condrea44/Voltage_Regulator/Documentatie.pdf

Universitatea Națională de Știință și Tehnologie POLITEHNICA București

Facultatea de Electronică, Telecomunicații și Tehnologia

Informației Specializarea MON

## Circuite Electronice Fundamentale 2 – Proiect Stabilizator cu ERS

Student: CondreaCosmin

Grupa: 432E-MON

Anul: 2024-2025

## Cuprins:

1. Tema Proiectului | pg. 3
2. Schema Bloc | pg.4
3. Schema Electrică | pg.5
4. Componența Circuitului și Calcule de Dimensionare | pg.6
5. Simulări in OrCAD | pg.10
6. CalculAnalitic | pg.17

## Tema proiectului

Se proiectează un stabilizator de tensiune cu element de reglaj serie cu următoarele caracteristici: N=10

- Tensiunea de ieșire reglabilă în intervalul: 5V-10V
- Sarcina la ieșire 500Ω
- Deriva termică < 2mV/grad C;
- Protecție la suprasarcină prin limitarea temperaturii tranzistorului element de reglaj serie la 100 grade C și a curentului maxim la 0,4A;
- Tensiune de intrare în intervalul: 18V-20V
- Domeniul temperaturilor de funcționare: 0-70 grade C (verificabil prin testare în temperatură);
- Amplificarea în tensiune minimă (în buclă deschisă) a amplificatorului de eroare: minim 200;

## Schema Bloc

Un stabilizator de tensiune cu element de reglare în serie (ERS) utilizează un amplificator de eroare pentru a menține stabilitatea tensiunii de ieșire. Acest amplificator compară o parte din tensiunea de referință (REF) cu un semnal preluat de la ieșire printr-un circuit de reacție. Diferența rezultată determină ajustarea elementului de reglare, compensând astfel variațiile tensiunii de intrare sau ale sarcinii.

În plus, circuitul include mecanisme de protecție pentru a preveni deteriorările:

1. Protecție la suprasarcină – care evită deteriorarea componentei regulatorului în cazul unui curent prea mare.
2. Protecție termică – care oprește funcționarea dacă temperatura regulatorului depășește un nivel critic.

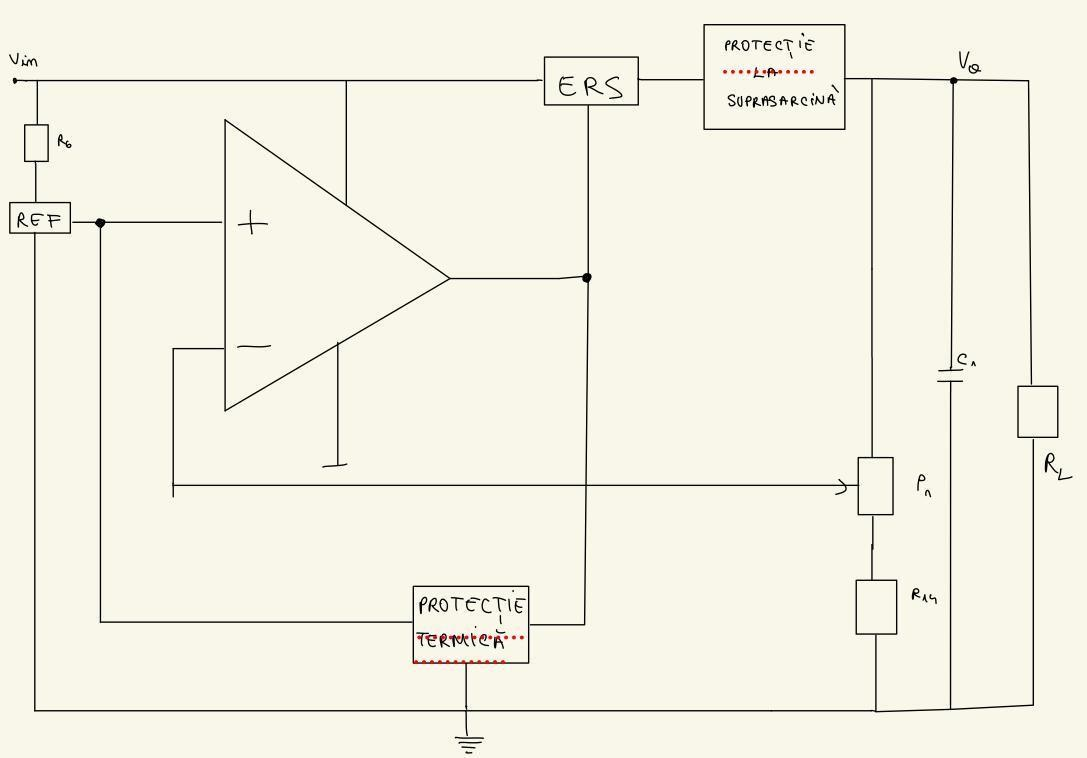
[picture p1: figure]

În schema dată, la intrarea neinversoare a amplificatorului de eroare este aplicată o tensiunea de referință (REF). La intrarea inversoare a amplificatorului de eroare este conectat un divizor rezistiv pentru a diviza Vout in funcție de ce valoare vrem să avem la ieșirea regulatorului.

Amplificatorul de eroare amplifica diferența dintre cele 2 intrări si comanda elementul de reglaj serie (ERS) pentru a stabiliza tensiunea de ieșire Vout.

## Schema Electrică

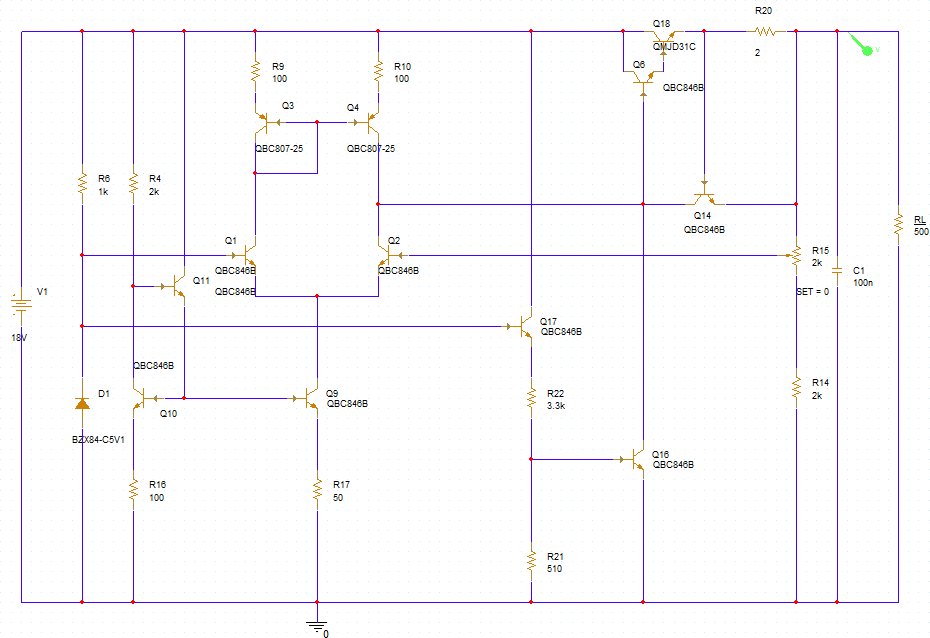
[picture p2: figure]

1. Amplificator de eroare: Q1, Q2, Q3, Q4, R9, R10 și generatorul de curent: Q9 ,Q10, Q11, R4, R16, R17;
2. Element de reglaj serie: Q6, Q18;
3. Referința de tensiune: D2;
4. Divizor de tensiune și rețea de reacție negativă: R15, R14;
5. Protecție termică: Q16, Q17, R22, R21;
6. Protecție la suprasarcină: Q14, R20;
Rezistor de sarcină: RL

## Componența Circuitului și Calcule de Dimensionare

1. Amplificatorul de eroare

Rolul amplificatorului de eroare este de a compara tensiunea de referință cu o fracțiune din tensiunea de ieșire. Diferența dintre acestea, este amplificată și folosită pentru a corecta funcționarea circuitului, asigurând menținerea unei tensiuni de ieșire stabile.

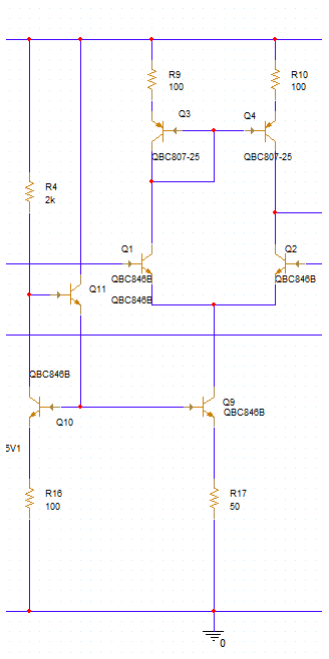
[picture p3: figure]

Amplificatorul de eroare este polarizat de o sursă de curent folosită in configurație de reducere a efectului de Beta. Acest tip de oglindă de curent folosește ca referință tensiunea bază-emitor și are o sensibilitate mai scazută față de alte oglinzi de curent. In etajul diferențial curentul dictat de dispozitivul Q9, se injumatațește. Putem observa ca etajul diferențial este format de Q1 si Q2 care au grilele la referințe de tensiune și sursele in scurt. Acesta conține o sarcină activă si 2 rezistoare ce impreună au ca scop creșterea amplificării in buclă deshisă, astfel oferind o tensiune de offset mai mică la ieșire. In urma numărarii etajelor de tip emitor comun, Q1 este intrarea neinversoare, iar Q2 este intrarea inversoare.

Dacă tensiunea de ieșire incepe să se modifice de la valoarea stabilită, diferența de tensiune va modifica la ieșirea diferențialului către ERS curentul astfel încât tensiunea de ieșire se va restabili.

2. Element de reglaj serie

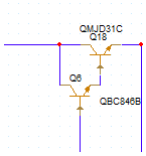
[picture p4: figure]

Perechea Darlington este o configurație de două tranzistoare bipolare conectate astfel încât primul tranzistor (Q6) preia semnalul de intrare, îl amplifică și furnizează un curent mai mare către baza celui de-al doilea tranzistor (Q18), care îl amplifică și mai mult. Rezultatul este un tranzistor compus cu un câștig total de curent aproximativ β1 * β2. Totuși, această configurație necesită o tensiune de prag mai mare 1.2V. Am folosit un tranzistor de putere intrucat pe acesta se disipa o putere maximă de aproximativ 0.2 W.

3. Referinta de tensiune

Referința de tensiune este realizată cu ajutorul unei diode Zener de tip BZX84-C5V, care menține o tensiune de străpungere stabilă de aproximativ 5.1V, atâta timp cât este traversată de un curent de cel puțin 5mA. Atunci când este alimentată cu un curent constant, această diodă prezintă un drift termic nesemnificativ în intervalul de temperatură 0 - 70°C, asigurând astfel o referință de tensiune precisă. Așa că am folosit un rezistor R6 cu valoarea rezistenței de 1kΩ pentru a produce un curent de 13mA in condițiile in care la intrare sursa de tensiune produce 18V.

4. Divizor de tensiune si rețea de reactie negativă

Datorită faptului ca am ales tensiunea de referință 5.1V am folosit un divizor rezistiv format dintr-un potențiometru si un rezistor de valori egale, astfel incat atunci când rotesc potențiometrul sa ajung la valorile conform cererii (5V-10V).

5. Protecția termică

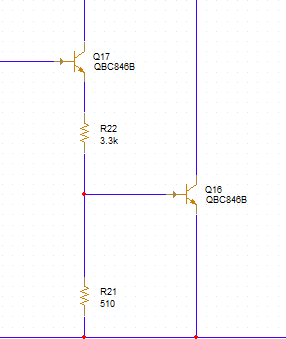
[picture p5: figure]

Am ales aceste valori ale rezistoarelor pentru a il folosi pe Q16 in regimul de blocare, pana cand temperatura circuitului crește la 100gradeC. In momentul in care se atinge această temperatură VBE-ul scade ( -2mV/°Celsius ) si astfel tranzistorul intră in conductie, trăgând tot curentul din iesirea amplificatorului si astfel provocând “Thermal Shutdown” cu scopul de a proteja componentele

6. Circuitul de protecție la suprasarcină

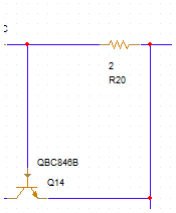
[picture p6: figure]

IO,lim = VBE14/R20 = 0.4A => R = 1.625Ω, dar am ales valoarea standard de 2Ω. Astfel, pentru curenți mai mici de 0.34A nu intră în funcțiune circuitul de protecție la suprasarcină, adica tranzistorul Q14 este în blocare.

## Simulări în OrCAD

I. Simulări pentru a arăta stabilizarea tensiunii de la iesire, in funcție de SET-ul potențiometruluiși tensiunea de intrare in circuit.

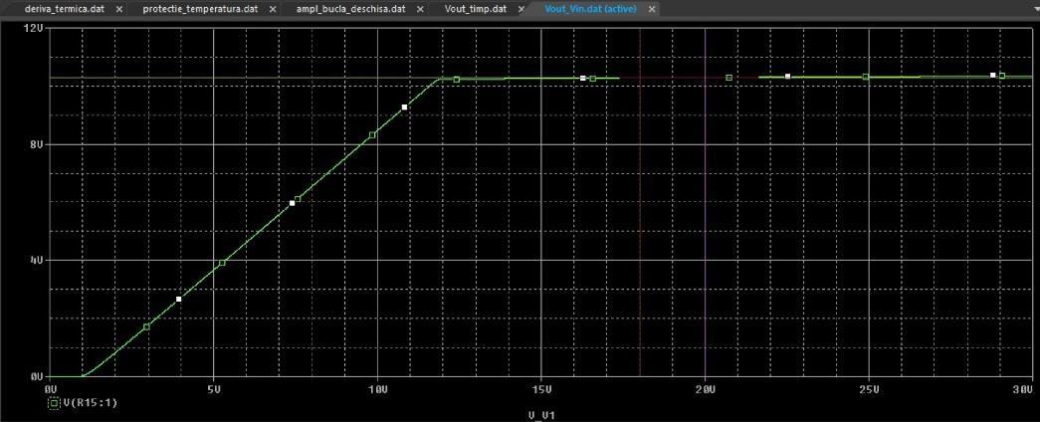
[picture p7: figure]

Vout= f(Vin) SET=0

Vout= f(Vin) SET=1

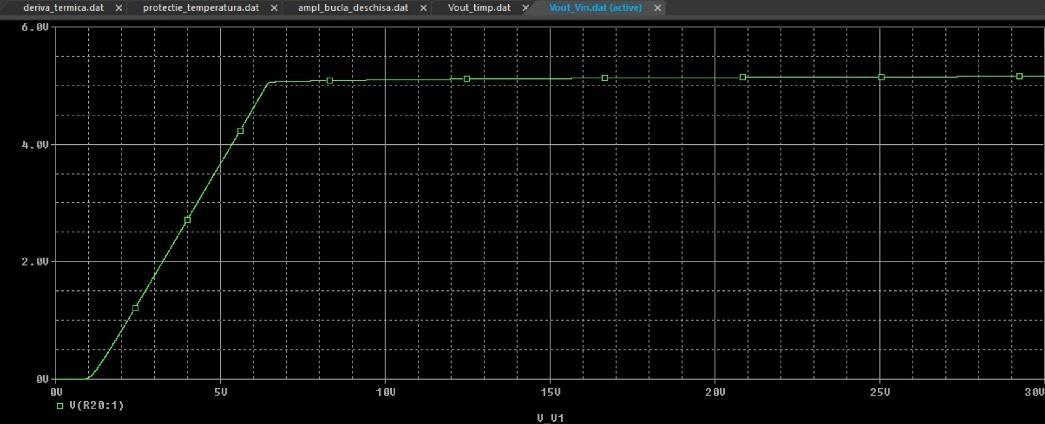
[picture p8: figure]

Se poate observa că tensiunea de ieșire Vout rămâne constantă atât în interiorul, cât și în afara intervalului de funcționare al tensiunii de intrare [5V - 10V]. Acest lucru demonstrează eficiența sistemului de feedback negativ, unde amplificatorul de eroare reglează automat semnalul de comandă aplicat tranzistoarelor pentru a compensa fluctuațiile sursei de alimentare. În plus, utilizarea unei configurații Darlington joacă un rol esențial în menținerea stabilității, datorită câștigului de curent ridicat, care permite tranzistoarelor să livreze un curent adecvat la ieșire fără pierderi semnificative. Faptul că Vout rămâne stabilă chiar și în condiții variabile indică o proiectare robustă a circuitului, ceea ce îl face potrivit pentru aplicații care necesită o tensiune de alimentare constantă și fiabilă.

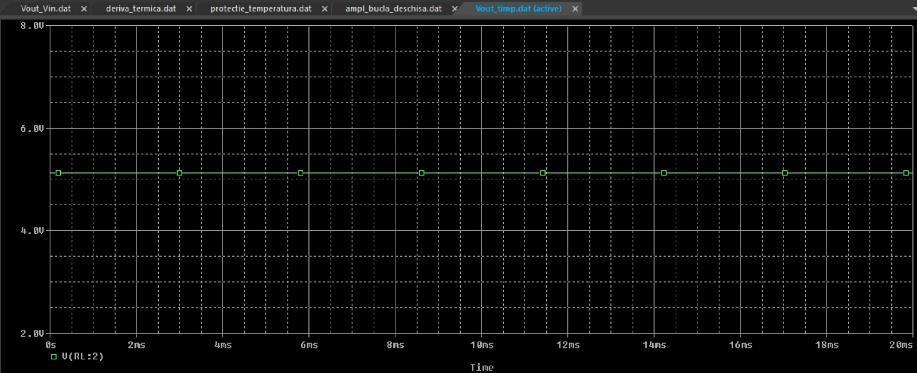
[picture p9: figure]

Vout= f(t) SET=1

Vout= f(t) SET=0

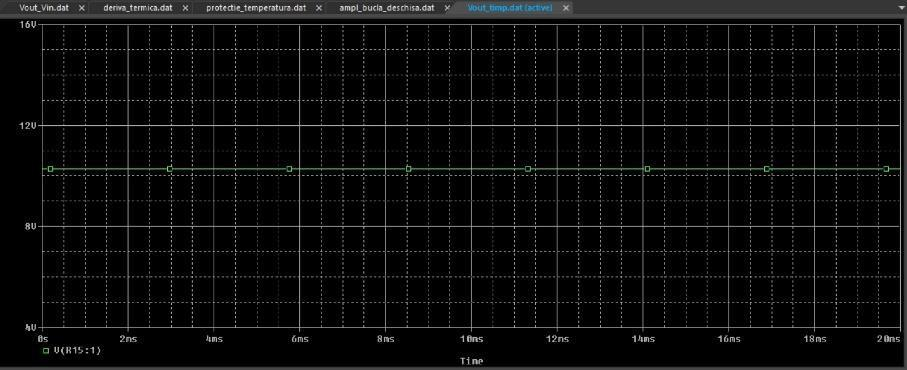
[picture p10: figure]

II. Simulări pentru deriva termică 0-70°C pentru valori limită ale lui Vout:

Vout= f(Temp) SET=1

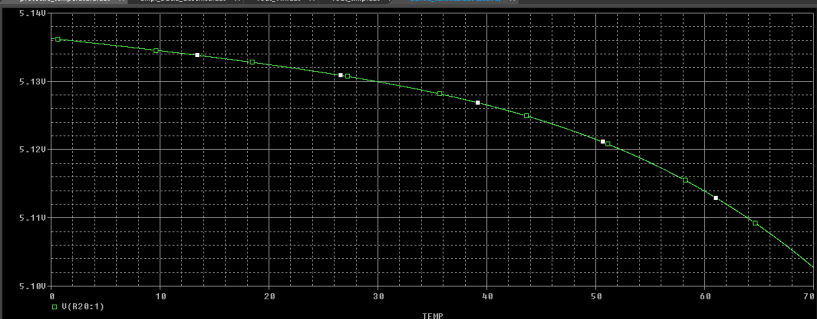
[picture p11: figure]

Calculez panta graficuluisi obțin deriva termică 0.48mV/°C.

Vout= f(Temp) SET=0

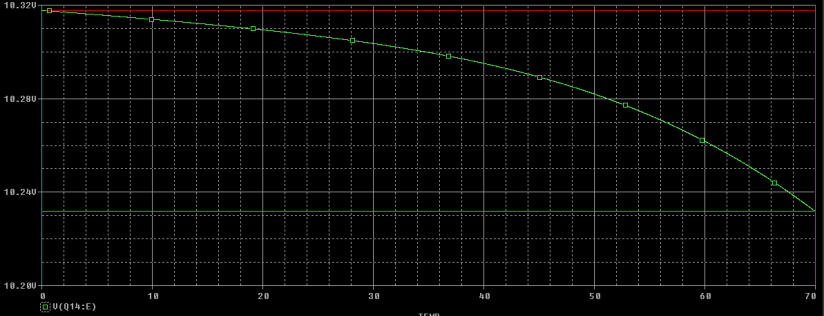
[picture p12: figure]

Calculez panta graficuluiși aici și obțin deriva termică 1.23mV/°C.

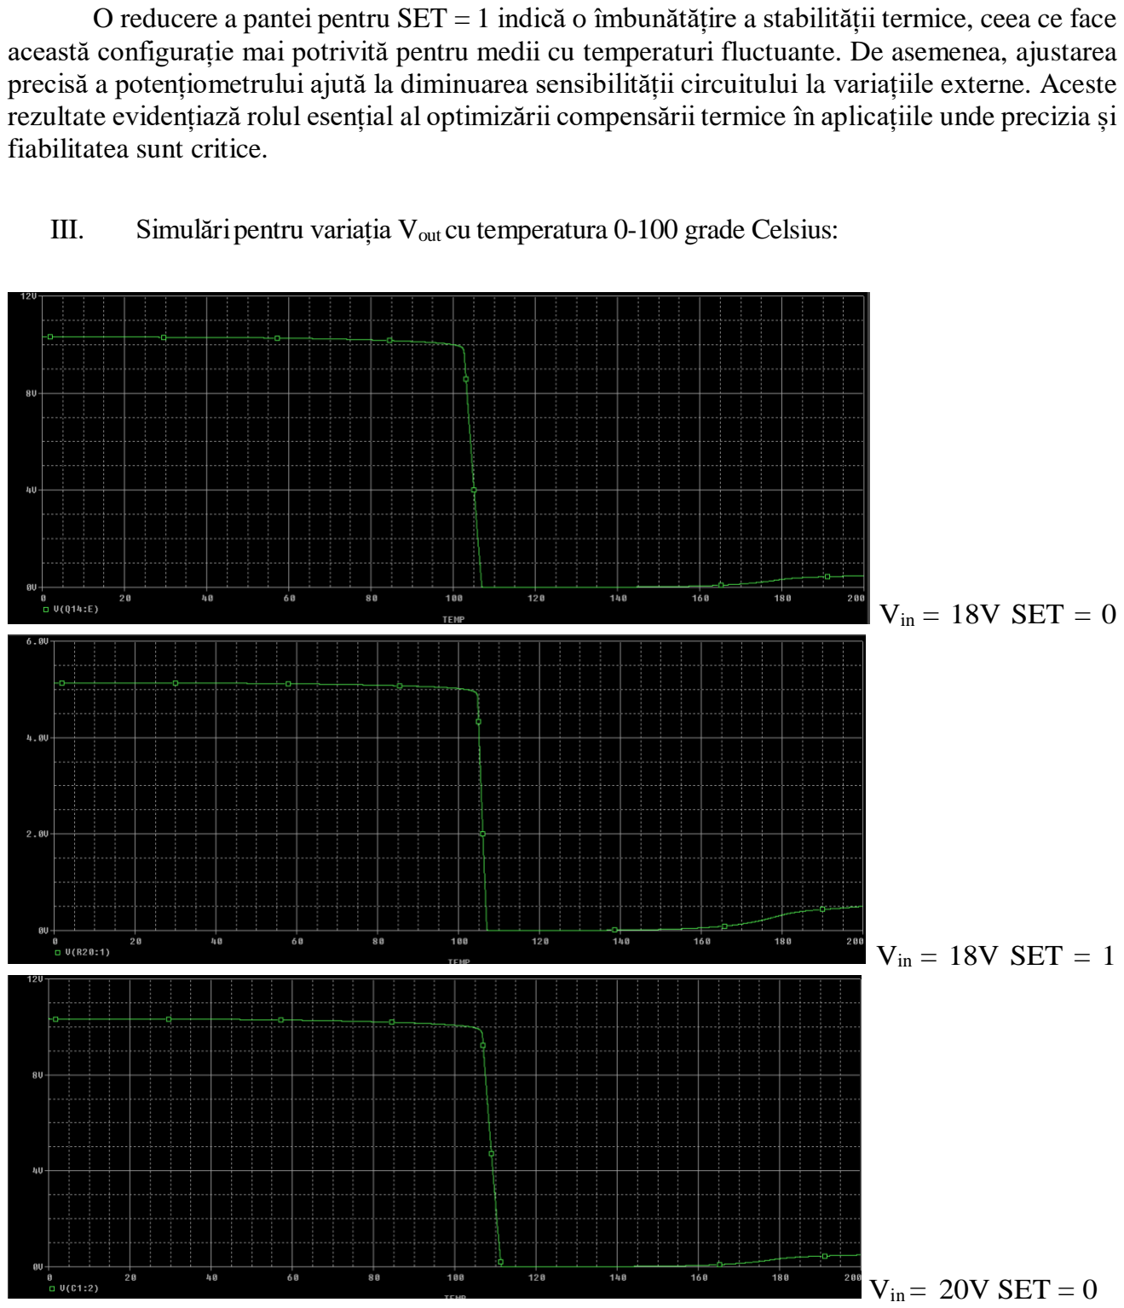
[picture p13: page 12]

O reducere a pantei pentru SET = 1 indică o îmbunătățire a stabilității termice, ceea ce face această configurație mai potrivită pentru medii cu temperaturi fluctuante. De asemenea, ajustarea precisă a potențiometrului ajută la diminuarea sensibilității circuitului la variațiile externe. Aceste rezultate evidențiază rolul esențial al optimizării compensării termice în aplicațiile unde precizia și fiabilitatea sunt critice.

III. Simulăripentru variația Vout cu temperatura 0-100 grade Celsius:

Vin = 18V SET = 0

Vin = 18V SET = 1

Vin = 20V SET = 0

Vin = 20V SET=1

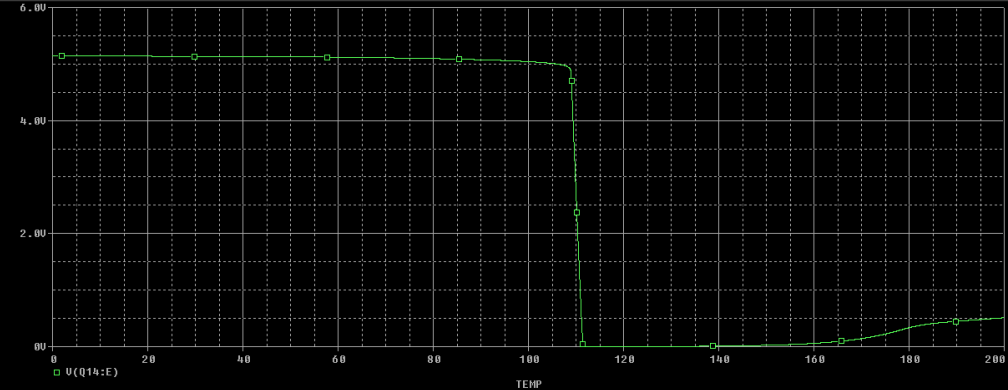
[picture p14: figure]

Simulările confirmă că Vout rămâne constant în intervalul de temperatură 0–100°C, ceea ce reflectă o stabilitate termică ridicată și o funcționare fiabilă a stabilizatorului în condiții normale de operare.
O scădere abruptă a tensiunii de ieșire în intervalul 100–120°Cindică activareamecanismului de protecție termică, care previne supraîncălzirea și protejează componentele esențiale ale circuitului. Pragul la care intervine această protecție poate fi ajustat prinmodificarea valorii rezistenței lui R22. De asemenea, circuitul este conceput pentru a funcționa în siguranță și la temperaturi negative, ceea ce îl face potrivit pentru aplicații expuse la variații extreme de temperatură. Acest comportament evidențiază importanța unei proiectări robuste și a unormecanisme eficiente de protecție înmedii solicitante.

IV. Simulare pentru evindențierea protecției la suprasarcină:

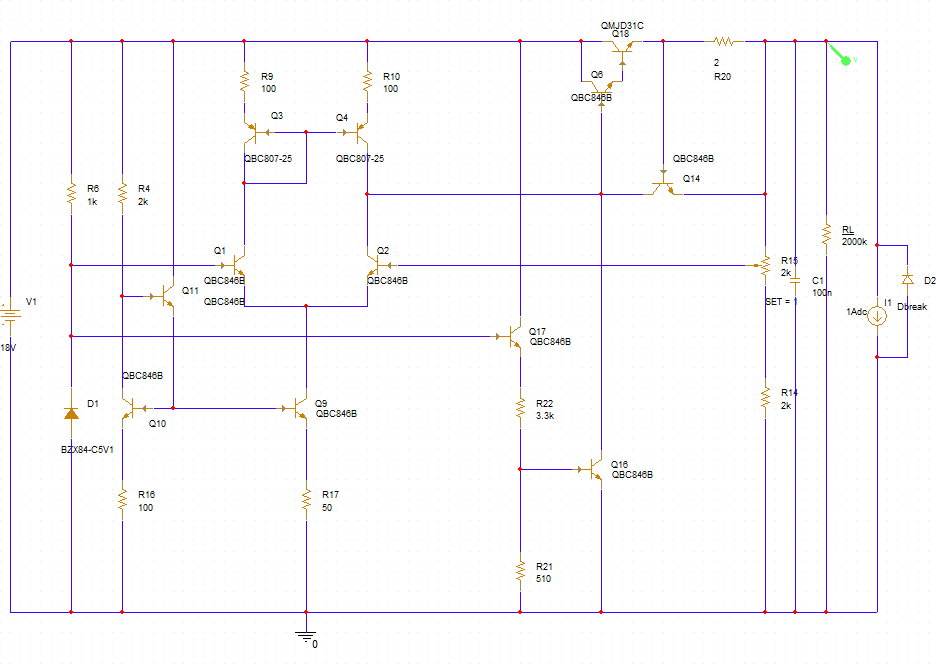
[picture p15: figure]

Pentru a simula IOlim, este necesarsă folosesc un rezistorde sarcină cu o valoare foartemare, astfel încât curentul de ieșire să fie extrem demic și să nu influențeze rezultatele simulării. În plus, la ieșire trebuie adăugată o sursă de curent DCvariabilă pentru a analiza comportamentul circuitului în diferite condiții.
Pentru a preveni o scădere excesivă a tensiunii de ieșire în domeniul negativ, circuitul include dioda D4 (Dbreak), care limitează tensiuneaminimă la un nivel controlat, protejând astfel stabilizatorul împotriva variațiilor extreme.

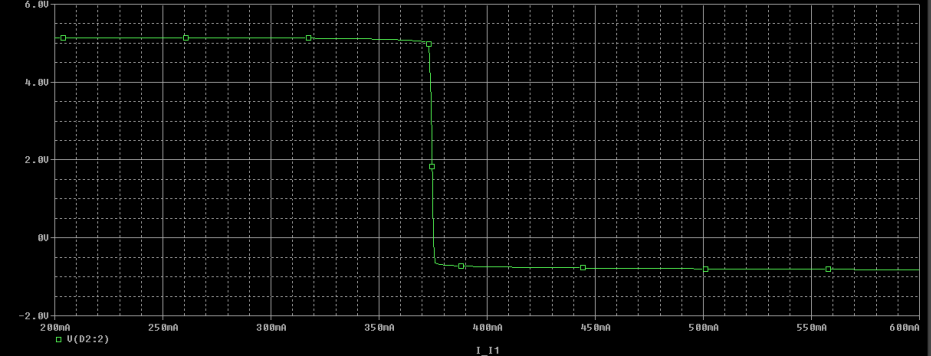
[picture p16: figure]

Graficul arată că, atunci când curentul de ieșire ajunge la 0.37mA,tensiuneaVoutscade brusc, semnalând activareamecanismului de protecție al circuitului. Această scăderemarchează punctul în care se declanșează limitarea curentului IOlim, împiedicând depășirea valorii maxime admise de stabilizator.

Acest mecanism este conceputspecial pentru a proteja tranzistoarele și celelalte componente critice de supraîncălzire sau deteriorare. Răspunsul rapid al circuitului la atingerea pragului de limitare confirmă eficiența protecției și asigură o funcționare sigură șistabilă în condiții de suprasarcină.

V. Amplificarea in buclă deschisă

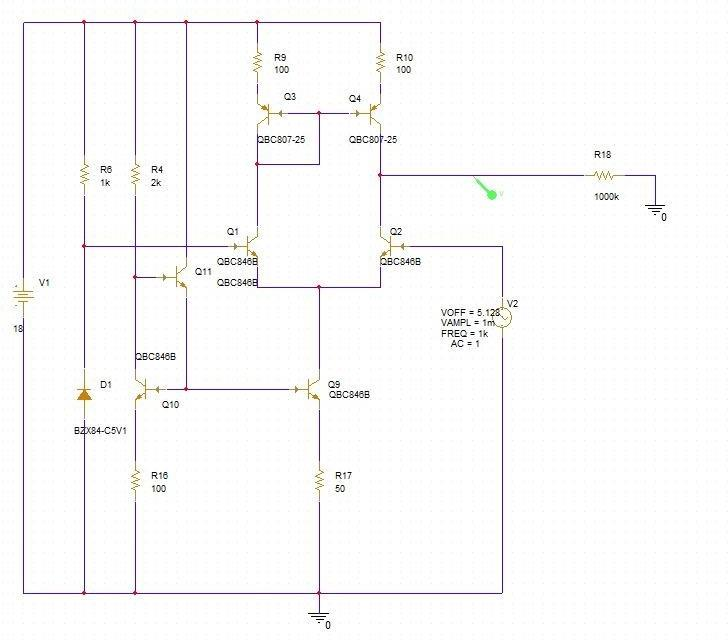
[picture p17: figure]

În această configurație ajustată, circuitul a fost modificat pentru a examina răspunsul amplificatorului diferențial fără influența reacției negative. S-a aplicat o tensiune sinusoidală la intrarea inversoare, în timp ce la intrarea neinversoare s-amenținut o tensiune de curent continuu fixă. Acest setup permite observarea directă amodului în care amplificatorul diferențial reacționează la variațiile semnalului de intrare.
Rezultatele simulării arată că tensiunea de ieșire suferă o tranziție bruscă atunci când semnalul de intrare depășește un anumit prag. Acest comportament evidențiază funcția de comparație a amplificatorului, care începe să devieze rapid atunci când tensiunea aplicată pe intrarea inversoare o depășește pe cea a intrării neinversoare.
Prin eliminarea reacției negative,s-a putut observa răspunsul pur al amplificatorului diferențial, ceea ce este util atât pentru înțelegerea principiuluisău de funcționare, câtși pentru ajustarea parametrilorîn vederea optimizării performanței.
Pentru a crește curenții din etajul diferențial,s-a ales o configurație în care raportul dintre anumiți rezistori a fost ajustat astfel încât curentul printr-unul dintre tranzistoare să fiemai mare decât în varianta inițială. Mai exact,s-a impus o relație între rezistențele utilizate astfel încât Ic9> Ic10, determinând o creștere a curenților prin perechea diferențială.
În calculul amplificăriis-a utilizatrelația specifică tranzistoarelorîn configurație sursă comună: Av = −gm⋅ RL
unde gm reprezintă transconductanța tranzistoruluiși este dată de:
gm= 40 * Ic
Pentru a obține un câștigmai mare de peste 200,s-a ales o strategie de creștere a transconductanței prinmărirea curentului de colector al tranzistorului Q2. Acest lucru a permisîmbunătățirea amplificării, atingând valoarea dorită pentru funcționarea optimă a circuitului.

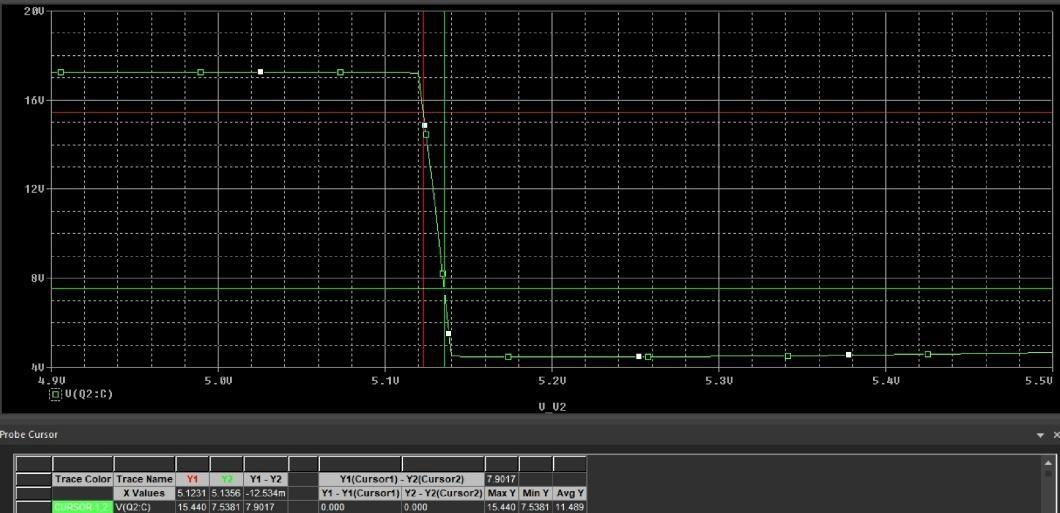
[picture p18: figure]

## Calcul Analitic

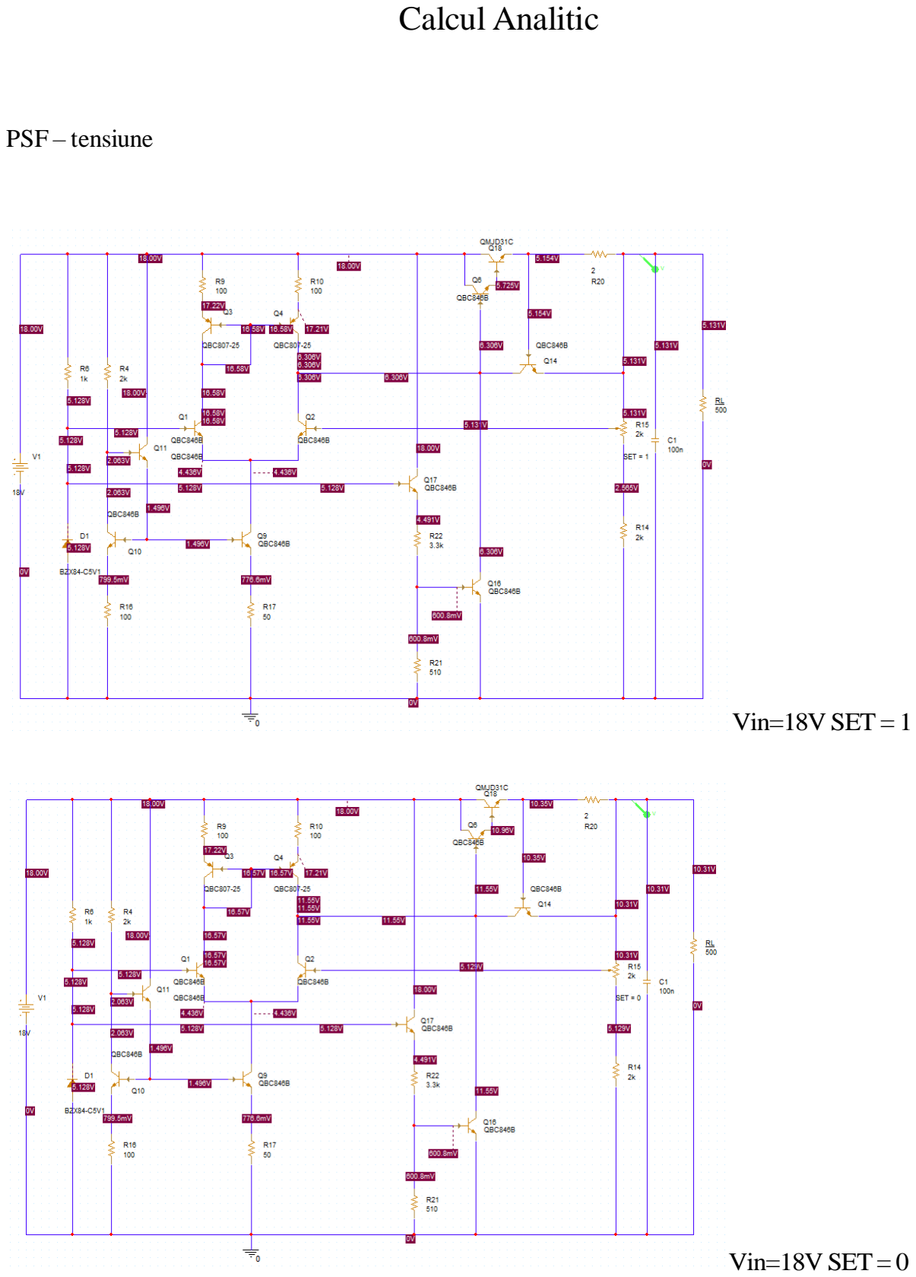
[picture p19: page 17]

PSF – tensiune

Vin=18V SET = 1

Vin=18V SET= 0

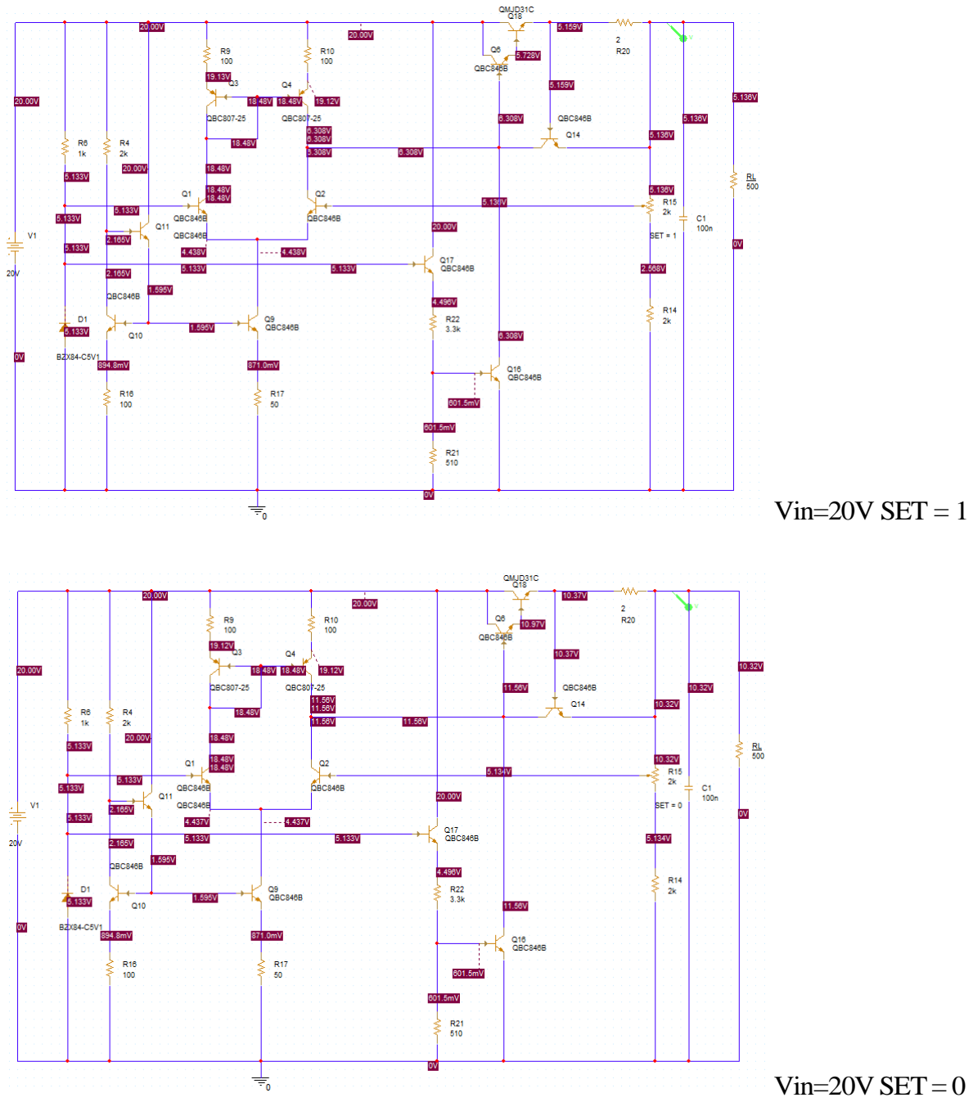
[picture p20: page 18]

Vin=20V SET = 1

Vin=20V SET= 0

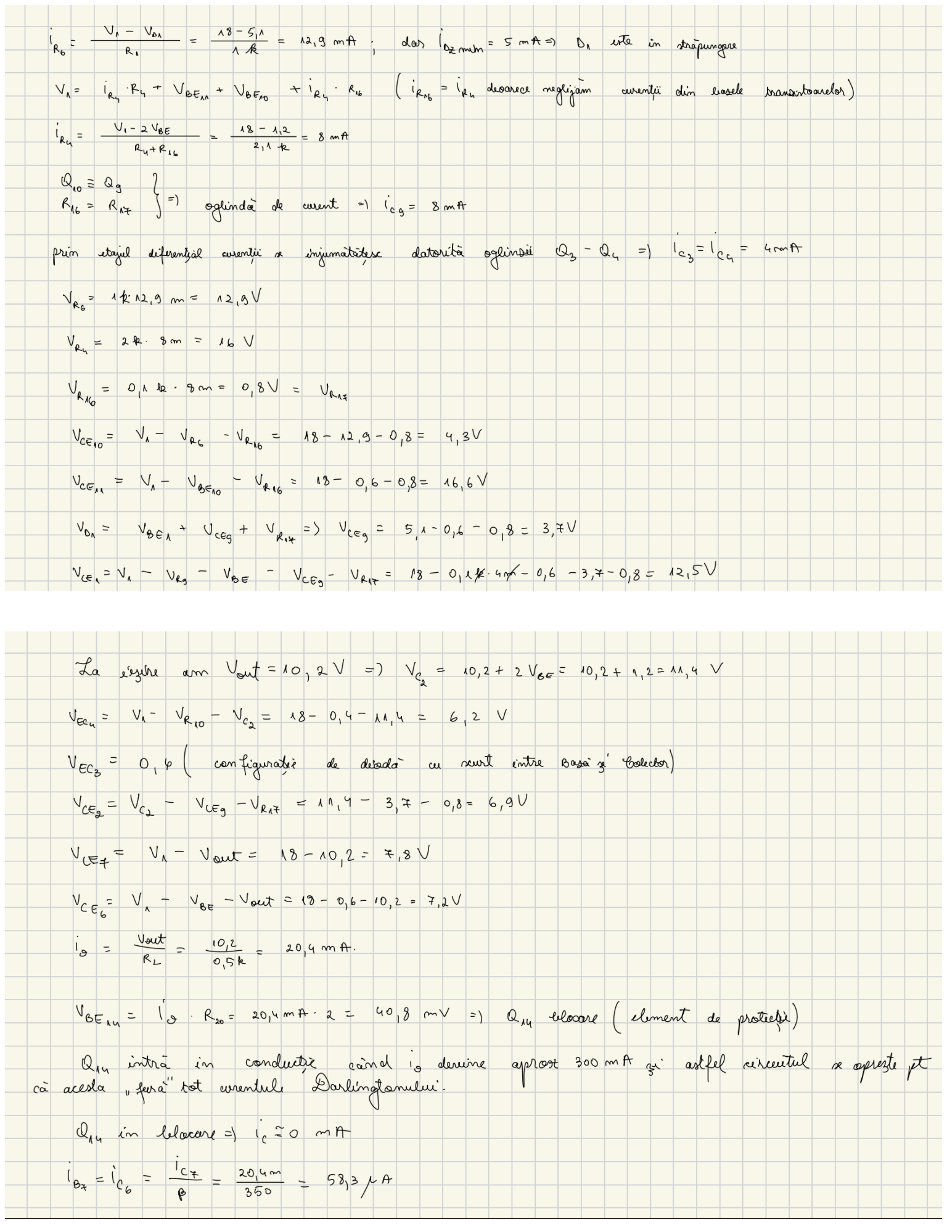
[picture p21: page 19]

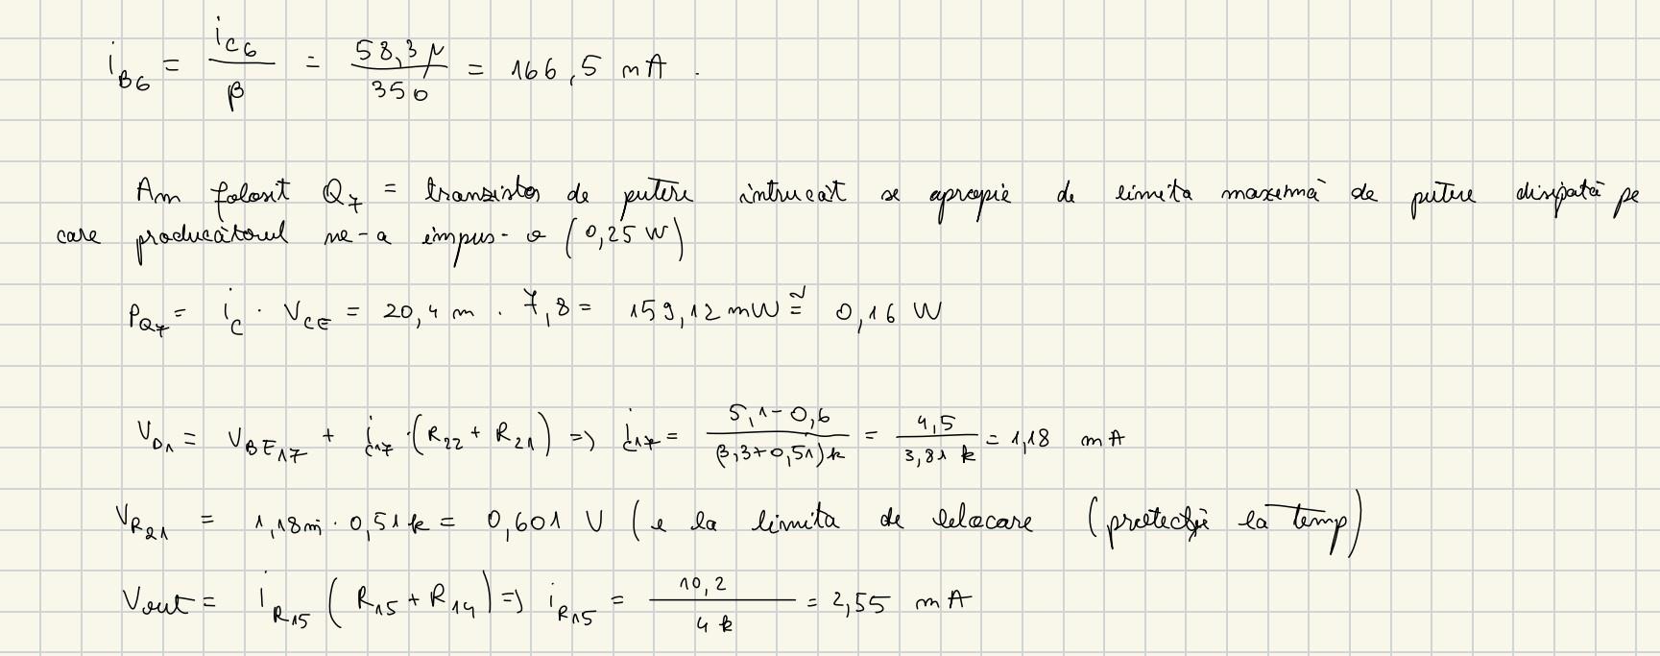
[picture p22: figure]
