condrea44/Voltage_Regulator/STABILIZATOR_DE_TENSIUNE.png

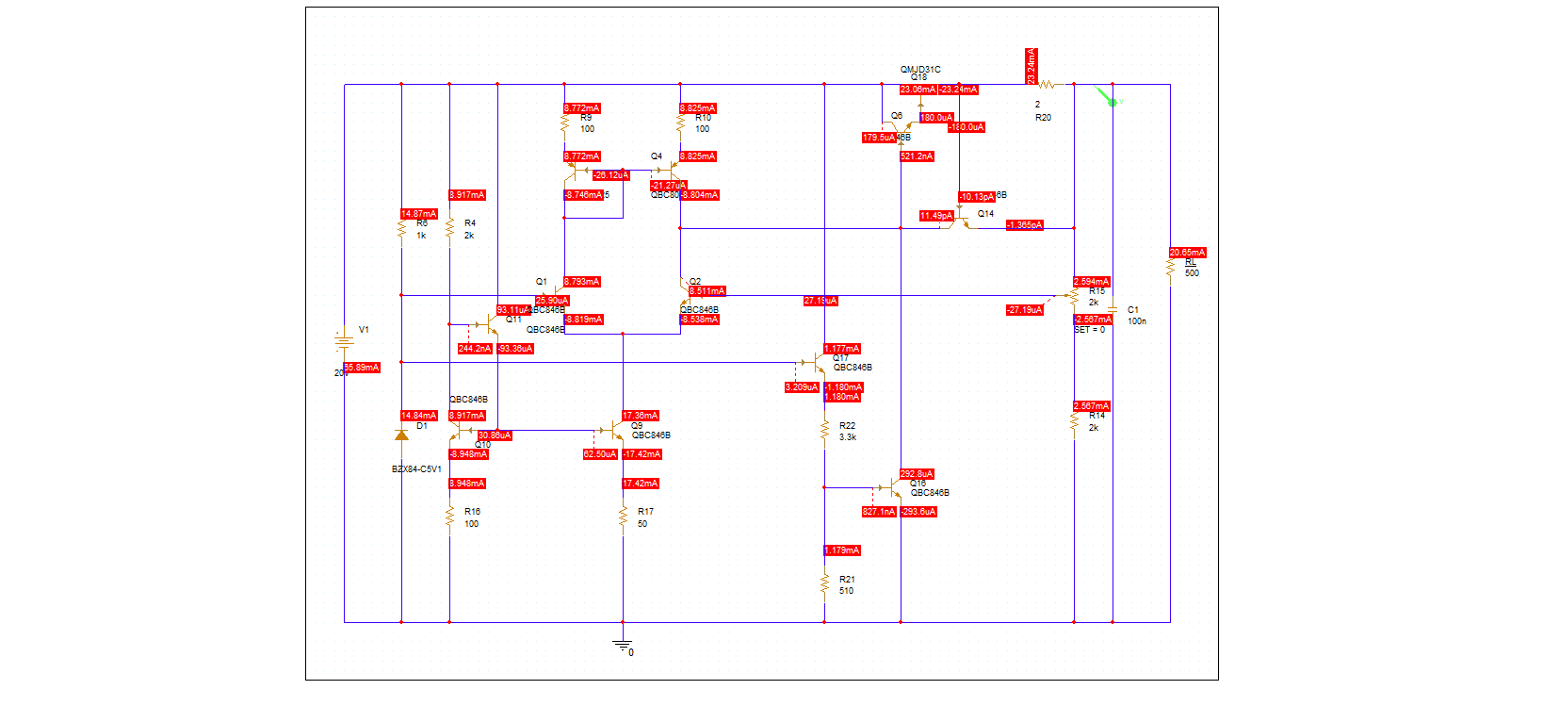
STABILIZATOR_DE_TENSIUNE.png
