condrea44/Voltage_Regulator/(list of files, drawings)

Other design files:
STABILIZATOR_DE_TENSIUNE.DSN
stabilizator_de_tensiune.opj
