condrea44/Voltage_Regulator/(commit log)

2025-03-07 Primul commit
    [STABILIZATOR_DE_TENSIUNE.DSN, bom.sch.csv, srceng.bom.sch.csv, stabilizator_de_tensiune.opj]
2025-03-17 am adaugat documentatia
    [STABILIZATOR_DE_TENSIUNE.DSN, bom.sch.csv, srceng.bom.sch.csv, stabilizator_de_tensiune.opj]
